Shriyans406/FLYBACK-CONVERTER/pcb/fab/ERC_report.txt

ERC report (2026-11-11T09:52:20, Encoding UTF8)
Report includes: Errors, Warnings, Exclusions

***** Sheet /

 ** ERC messages: 0  Errors 0  Warnings 0

 ** Ignored checks:
    - Global label only appears once in the schematic
    - Four connection points are joined together
    - SPICE model issue
    - Assigned footprint doesn't match footprint filters
