Shriyans406/FLYBACK-CONVERTER/pcb/renders/bottom.png

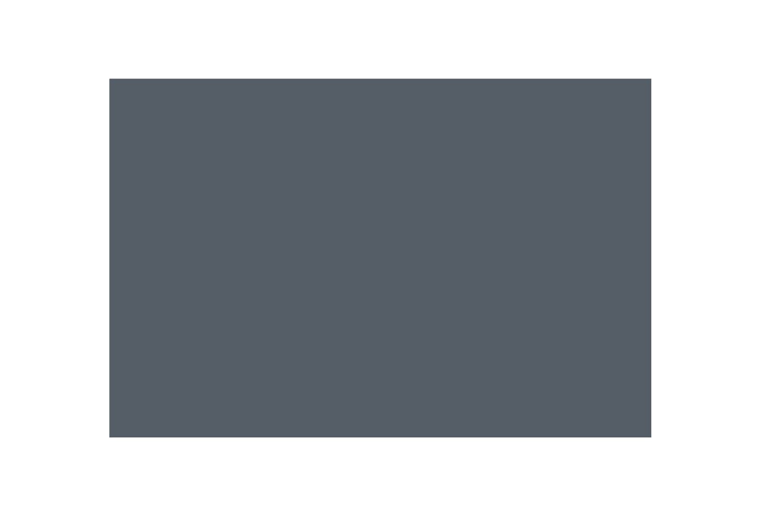
pcb/renders/bottom.png
