Shriyans406/FLYBACK-CONVERTER/pcb/renders/enclosure_view.png

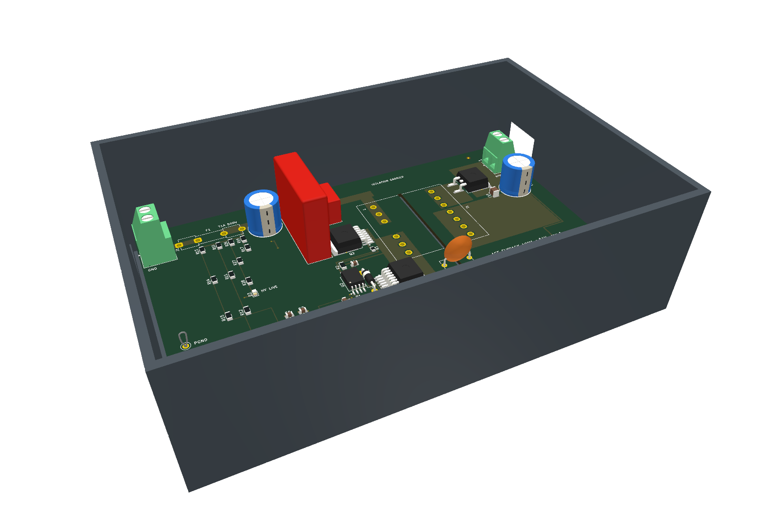
pcb/renders/enclosure_view.png
