Shriyans406/FLYBACK-CONVERTER/pcb/renders/top.png

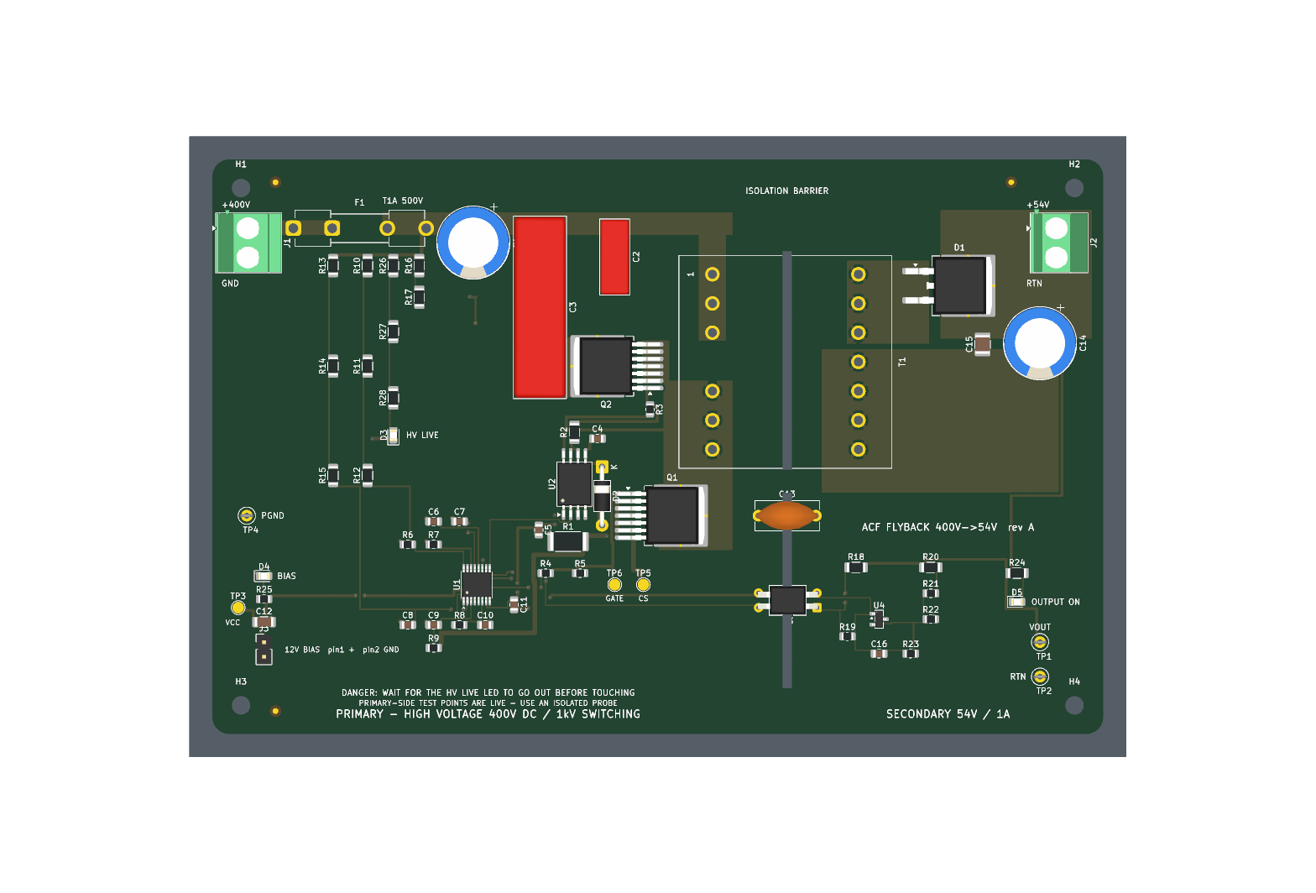
pcb/renders/top.png
