Shriyans406/FLYBACK-CONVERTER/pcb/fab/ACF_Flyback_BOM.csv

Qty | References | Value | Footprint | Description
1 | J1 | 400V DC IN | TerminalBlock_Phoenix_MKDS-3-2-5.08_1x02_P5.08mm_Horizontal | Phoenix MKDS 3/2-5,08
1 | F1 | T1A 500V | Fuseholder_Clip-5x20mm_Keystone_3517_Inline_P23.11x6.76mm_D1.70mm_Horizontal | Keystone 3517 clips + 5x20 fuse
1 | C1 | 22u 450V | CP_Radial_D12.5mm_P5.00mm | bulk electrolytic
1 | C2 | 100n 630V | C_Rect_L13.0mm_W5.0mm_P10.00mm_FKS3_FKP3_MKS4 | film, HF loop bypass
1 | C3 | 470n 1kV | C_Rect_L31.5mm_W9.0mm_P27.50mm_MKS4 | film clamp capacitor
1 | T1 | 25mH 10:1 | Transformer_EPCOS_B66359A1013T_Horizontal | PLACEHOLDER ETD29 bobbin - see notes
1 | Q1 | IMBF170R1K0M1 | TO-263-7_TabPin8 | Infineon 1700V SiC, main switch
1 | Q2 | IMBF170R1K0M1 | TO-263-7_TabPin8 | Infineon 1700V SiC, clamp switch
1 | R1 | 0R27 1W | R_2512_6332Metric | current sense
1 | U2 | UCC5350SBDWV | SOIC-8_7.5x5.85mm_P1.27mm | isolated high-side gate driver
1 | C4 | 1u 25V | C_0805_2012Metric | bootstrap capacitor
1 | R2 | 10R | R_1206_3216Metric | Q2 gate resistor
1 | R3 | 10k | R_0805_2012Metric | Q2 gate pull-down
1 | D2 | STTH112 | D_DO-41_SOD81_P10.16mm_Horizontal | 1200V bootstrap diode
1 | C5 | 100n | C_0805_2012Metric | U2 input decoupling
1 | R4 | 10R | R_0805_2012Metric | Q1 gate resistor
1 | R5 | 10k | R_0805_2012Metric | Q1 gate pull-down
1 | U1 | LM5025 | TSSOP-16_4.4x5mm_P0.65mm | active-clamp PWM controller
1 | R6 | 22k | R_0805_2012Metric | UVLO divider bottom
1 | R7 | 680k | R_0805_2012Metric | oscillator (10 kHz, see notes)
1 | C6 | 100n | C_0805_2012Metric | soft-start
1 | C7 | 1n | C_0805_2012Metric | COMP noise filter
1 | C8 | 1n | C_0805_2012Metric | ramp capacitor
1 | C9 | 220p | C_0805_2012Metric | current-sense filter
1 | R8 | 160k | R_0805_2012Metric | dead-time set
1 | C10 | 100n | C_0805_2012Metric | REF decoupling
1 | R9 | 1k | R_0805_2012Metric | current-sense filter
1 | C11 | 1u 25V | C_0805_2012Metric | VCC decoupling
1 | C12 | 10u 25V | C_1206_3216Metric | VCC bulk
1 | J3 | 12V BIAS | PinHeader_1x02_P2.54mm_Vertical | primary-referenced 12 V bias input
3 | R10 R11 R12 | 1M | R_1206_3216Metric | UVLO divider
3 | R13 R14 R15 | 1M | R_1206_3216Metric | ramp feed-forward
2 | R16 R17 | 470k | R_1206_3216Metric | bulk bleeder
1 | C13 | 2n2 Y1 | C_Disc_D11.0mm_W5.0mm_P10.00mm | Y1 safety capacitor
1 | U3 | LTV-817M | DIP-4_W10.16mm | optocoupler, 10.16 mm lead form
1 | D1 | RB218NS150 | TO-263-2 | 150V 20A Schottky
1 | C14 | 180u 100V | CP_Radial_D12.5mm_P5.00mm | output electrolytic, low ESR
1 | C15 | 1u 100V | C_1210_3225Metric | output ceramic
1 | J2 | 54V OUT | TerminalBlock_Phoenix_MKDS-1,5-2-5.08_1x02_P5.08mm_Horizontal | Phoenix MKDS 1,5/2-5,08
1 | U4 | TL431 | SOT-23 | shunt reference (check K/R/A pin order of chosen vendor)
1 | R18 | 22k | R_1206_3216Metric | opto LED feed
1 | R19 | 1k | R_0805_2012Metric | TL431 bias
1 | R20 | 200k | R_1206_3216Metric | feedback divider top
1 | R21 | 6k2 | R_0805_2012Metric | feedback divider top
1 | R22 | 10k | R_0805_2012Metric | feedback divider bottom
1 | C16 | 100n | C_0805_2012Metric | Type-II compensation
1 | R23 | 10k | R_0805_2012Metric | Type-II compensation
3 | R26 R27 R28 | 220k | R_1206_3216Metric | HV-live LED dropper
1 | D3 | RED | LED_0805_2012Metric | HV LIVE indicator (bulk capacitor charged)
1 | R25 | 4k7 | R_0805_2012Metric | bias LED resistor
1 | D4 | YELLOW | LED_0805_2012Metric | 12 V BIAS indicator
1 | R24 | 27k | R_1206_3216Metric | output LED resistor
1 | D5 | GREEN | LED_0805_2012Metric | OUTPUT ON indicator
1 | TP1 | VOUT | TestPoint_Loop_D2.50mm_Drill1.0mm | probe loop, +54 V output
1 | TP2 | SGND | TestPoint_Loop_D2.50mm_Drill1.0mm | probe loop, output return
1 | TP4 | PGND | TestPoint_Loop_D2.50mm_Drill1.0mm | probe loop, primary ground
