Shriyans406/FLYBACK-CONVERTER/pcb/enclosure/ACF_enclosure_base.stl

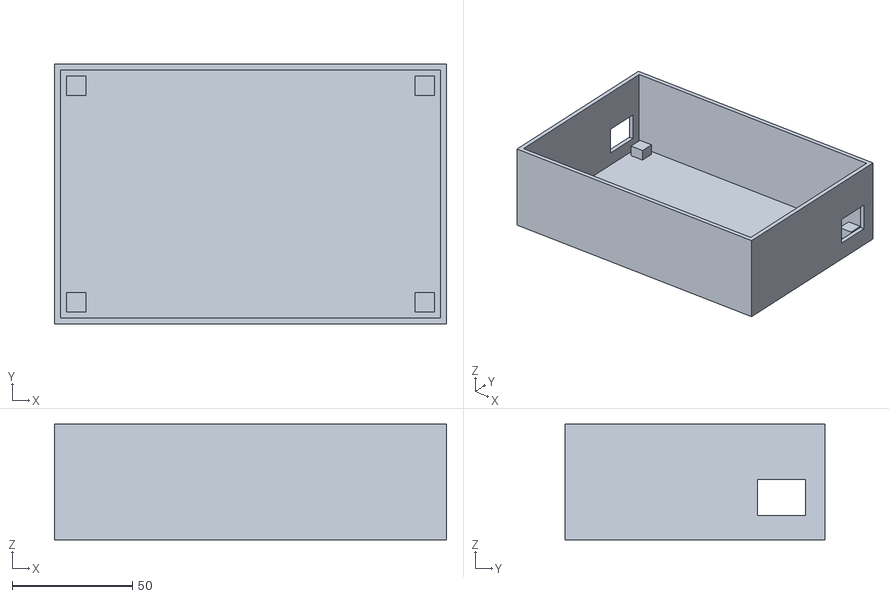
[picture p4: CAD file, 2026-11-11]
pcb/enclosure/ACF_enclosure_base.stl
163.0 x 108.0 x 48.1
