Shriyans406/FLYBACK-CONVERTER/pcb/enclosure/ACF_enclosure_lid.stl

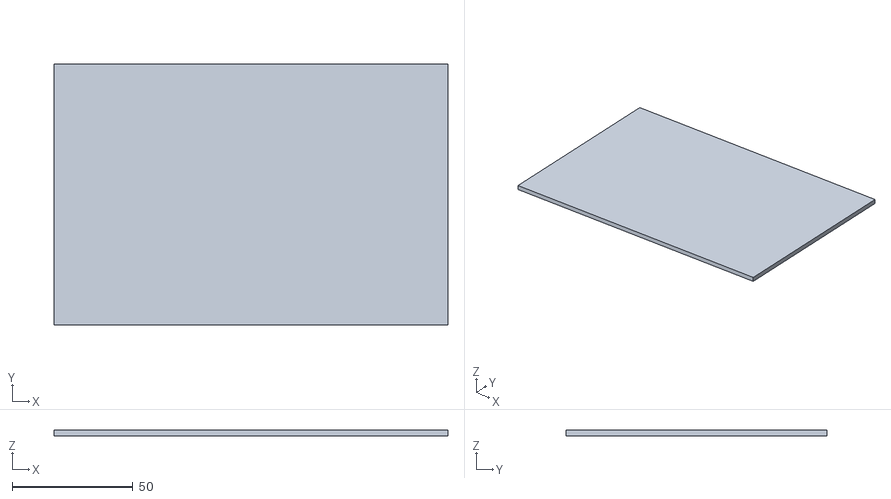
[picture p5: CAD file, 2026-11-11]
pcb/enclosure/ACF_enclosure_lid.stl
163.0 x 108.0 x 2.50
