Shriyans406/FLYBACK-CONVERTER/ACF_verification.png

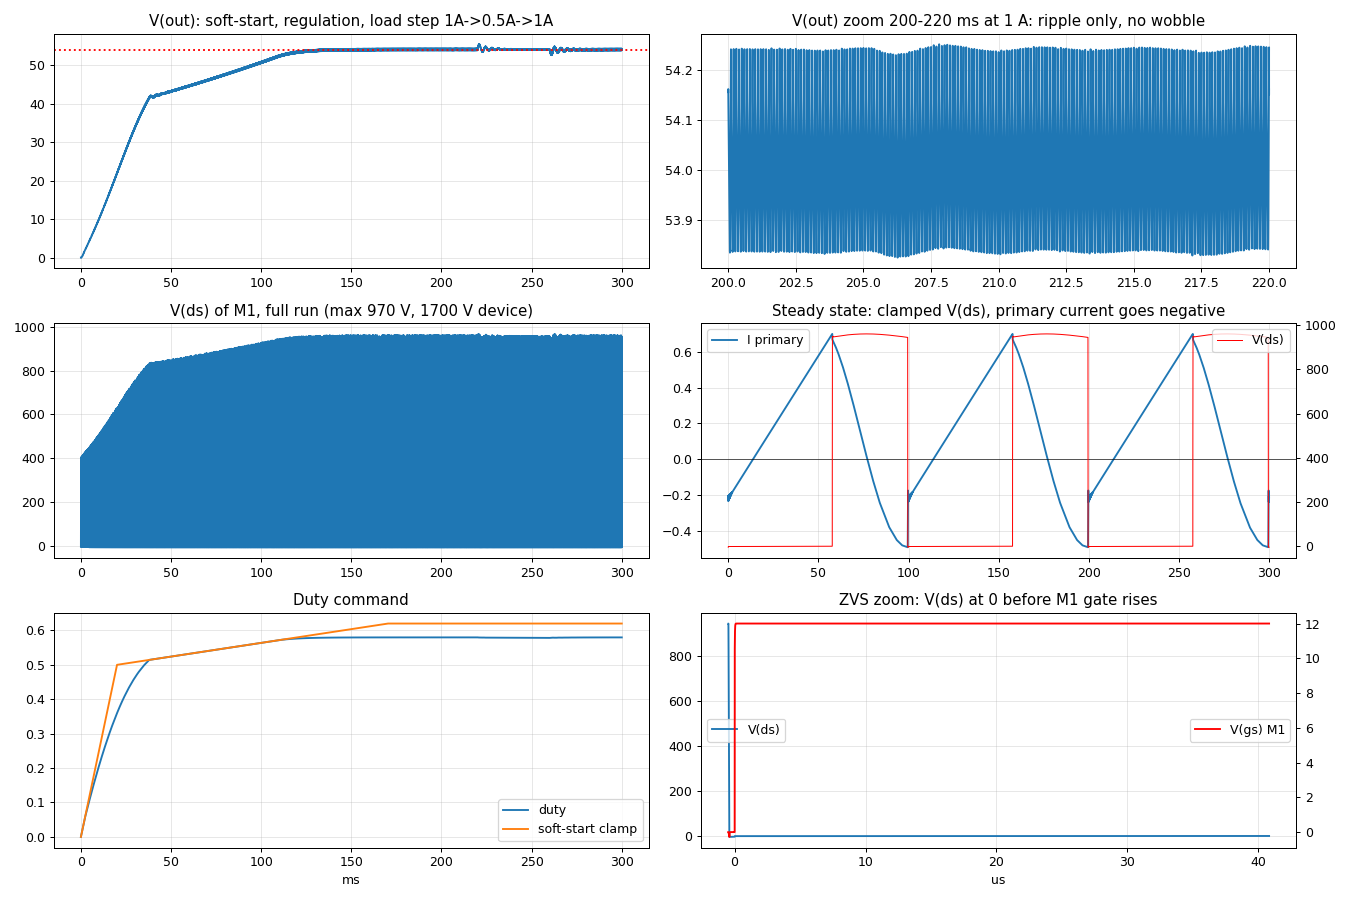
ACF_verification.png
