Shriyans406/FLYBACK-CONVERTER/pcb/fab/ACF_Flyback_schematic.pdf

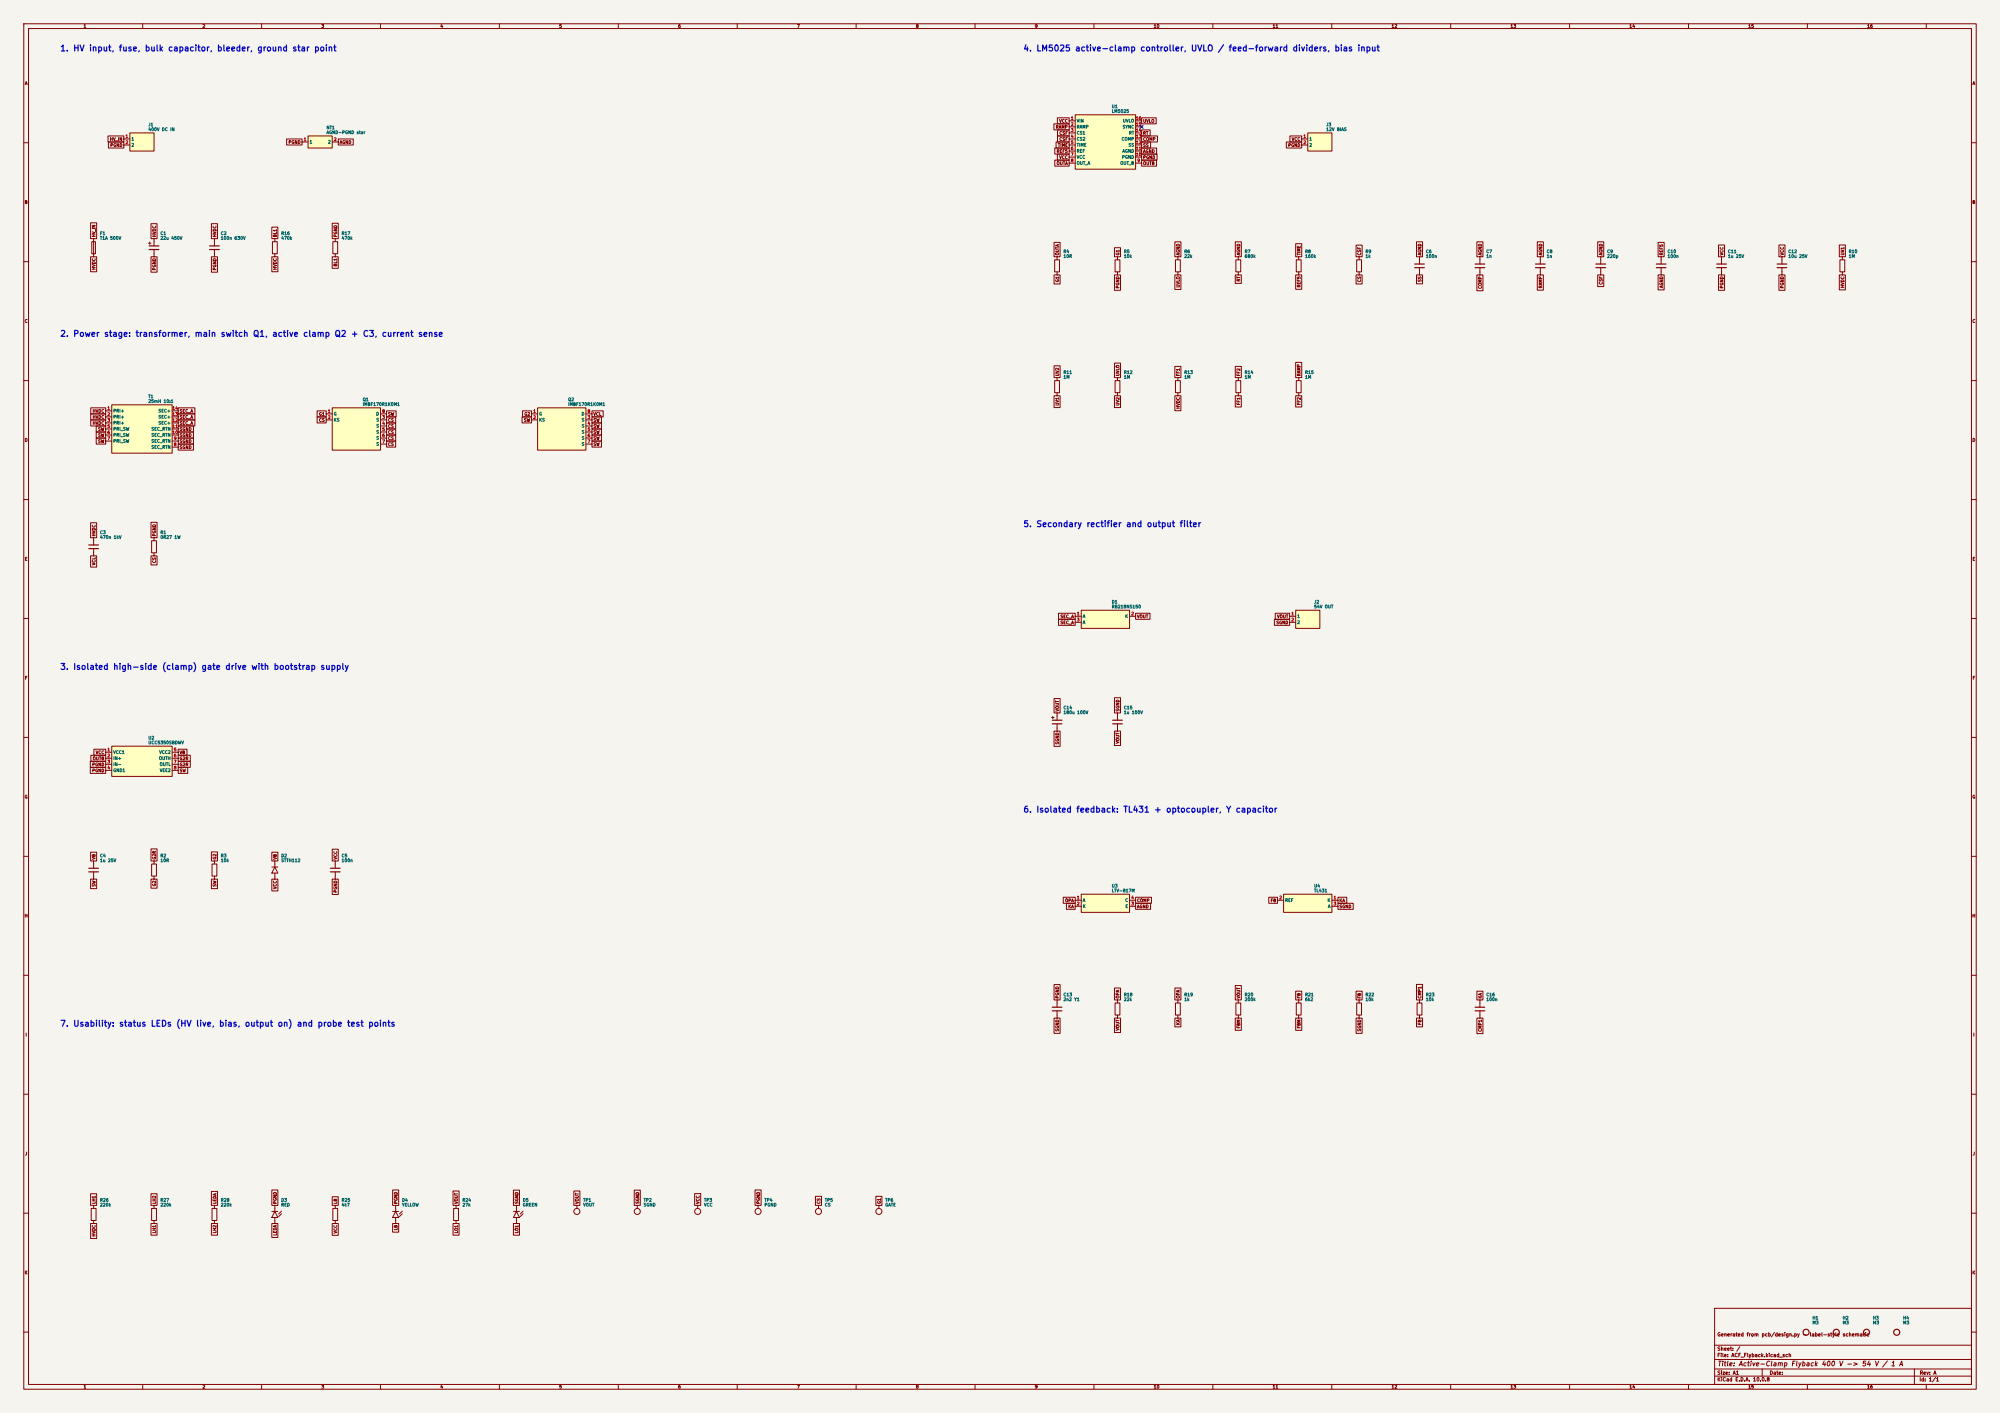
[picture p7: page 1]

1. HV input, fuse, bulk capacitor, bleeder, ground star point

4. LM5025 active-clamp controller, UVLO / feed-forward dividers, bias input

2. Power stage: transformer, main switch Q1, active clamp Q2 + C3, current sense

SGND HVDC HVDC HVDC

5. Secondary rectifier and output filter

3. Isolated high-side (clamp) gate drive with bootstrap supply

6. Isolated feedback: TL431 + optocoupler, Y capacitor

7. Usability: status LEDs (HV live, bias, output on) and probe test points

Generated from pcb/design.py - label-style schematic

Sheet: /
File: ACF_Flyback.kicad_sch
Title: Active-Clamp Flyback 400 V -> 54 V / 1 A

Size: A1 | Rev: A
KiCad E.D.A. 10.0.8 | Id: 1/1
