Shriyans406/FLYBACK-CONVERTER/07-06-26_Sunday_FLyback.asc

Cclamp: cap; 10n
Cin: cap; 100n
Co2: cap; 470µ
D1: diode; 1N4007
L1: ind2; 500µ
L2: ind2; 5µ
M1: nmos; MY_NMOS
M2: pmos; IRF9640
R1: res; 10
Vgate2: voltage; PULSE(400 390 5.2u 10n 10n 4.4u 10u)
Vgate: voltage; PULSE(0 10 0 10n 10n 5u 10u)
Vin: voltage; 400
Named nets: 0
K1 L1 L2 0.98
.tran 0 5m 2m startup
.model MY_NMOS NMOS(Vto=4 Kp=20 TOX=20n CGSO=1n CGDO=50p)
