Shriyans406/FLYBACK-CONVERTER/11-07-26.asc

B1: bv; V=ls(V(ramp),V(duty),V(clk))
B2: bv; V=hs(V(ramp),V(duty),V(clk))
Baw: bi; I=0.1*(max(V(v_err)-V(ss),0)-max(-V(v_err),0))
Bduty: bv; V=limit(min(V(v_err),V(ss)),0,0.62)
C1: cap; 180u; Rser=30m
C2: cap; 4.7u
C3: cap; 100n
Cclamp: cap; 470n
D1: schottky; RB218NS150
Istep: current; PWL(0 0 220m 0 220.1m -0.5 260m -0.5 260.1m 0)
L1: ind2; 25m; Rser=2
L2: ind2; 250u; Rser=20m
M1: nmos; IMBF170R1K0M1
M2: nmos; IMBF170R1K0M1
R1: res; 54
R2: res; 47
Rfb1: res; 515k
Rfb2: res; 25k
Ron1: res; 10
Ron2: res; 10
U1: opamp
V1: voltage; 2.5
Vclk: voltage; PULSE(0 1 0 10n 10n 99.5u 100u)
Vin1: voltage; 400
Vramp1: voltage; PULSE(0 1 0 99.5u 0.1u 0 100u)
Vss: voltage; PWL(0 0 20m 0.5 170m 0.62)
Named nets: 0, out, vpri, vsec, ctrl, gs, ds, vfb, v_err, ramp, vcl, g2, ctrl2, clk, ss, duty
K1 L1 L2 0.99
.tran 0 300m 0 startup
.model IMBF170R1K0M1 VDMOS(Rg=35 Vto=4.5 Kp=0.2 Rd=0.3 Rs=0.03 Cgs=274p Cgdmin=0.7p Cgdmax=60p A=0.5 Cjo=119p M=0.5 Vj=3 Is=1e-15 N=4 Rb=0.2 BV=1700 Vds=1700 Ron=1 Qg=5n mfg=Infineon)
.func ls(r,d,c) {if((r<d)&(c>0.5),12,0)}
.func hs(r,d,c) {if((r>d+0.005)&(c>0.5),12,0)}
.options reltol=0.001 cshunt=1p method=gear
.lib opamp.sub
.meas TRAN vout_avg AVG V(out) FROM 200m TO 220m
.meas TRAN vout_pp PP V(out) FROM 219m TO 220m
.meas TRAN pin AVG -V(vpri)*I(Vin1) FROM 200m TO 220m
.meas TRAN pout AVG V(out)*V(out)/54 FROM 200m TO 220m
.meas TRAN eff PARAM pout/pin
.meas TRAN duty_avg AVG V(duty) FROM 200m TO 220m
.meas TRAN vds_max MAX V(ds)
.meas TRAN vds_at_M1_turnon FIND V(ds) WHEN V(gs)=2 RISE=LAST
.meas TRAN vclamp_avg AVG V(vcl)-V(vpri) FROM 200m TO 220m
ACTIVE-CLAMP FLYBACK 400V -> 54V/1A, 10kHz, n=10:1
;M1/M2 = Infineon IMBF170R1K0M1 (1700V, 1 ohm SiC), datasheet-fit model
;Cclamp+M2 replace the RCD snubber: leakage energy is recycled
;Lm=25mH: magnetising current swings negative -> ZVS, no dead-time ringing
;hs/ls = complementary PWM with 0.5us dead-time
;Vss/Baw = duty soft-start + error-amp anti-windup clamp
;Istep = 1A -> 0.5A -> 1A load step (220-260ms) to check the loop
