Shriyans406/FLYBACK-CONVERTER/11-07-26_RCD_original.asc

B1: bv; V = IF((V(ramp) < V(v_err)) & (V(ramp) < 0.9), 10, 0)
C1: cap; 470µ
C2: cap; 2.798µ
C3: cap; 10.36n
Csnub1: cap; 14.5n
D1: schottky; RB218NS150
D2: schottky; RB218NS150
L1: ind2; 572µ
L2: ind2; 5.72µ
M1: nmos; REAL_MOSFET
R1: res; 54
R2: res; 4534.1
Rfb1: res; 51.5k
Rfb2: res; 2.5k
Ron1: res; 10
Rsnub1: res; 243.781k
U1: opamp
V1: voltage; 2.5
Vin1: voltage; 400
Vramp1: voltage; PULSE(0 1 0 99.9u 0.1u 0 100u)
Named nets: 0, out, d2, vpri, vsec, ctrl, gs, ds, vfb, v_err, ramp
K1 L1 L2 0.99
.tran 0 100m 2m startup
.model IDEAL_MOS NMOS(Vto=2 Kp=10000 Rd=0.001)
.lib opamp.sub
.model REAL_MOSFET NMOS(Vto=4 Kp=15 Rd=1.0 Cgso=50p Cgdo=10p)
.options reltol=0.01
.options cshunt=1p
.options method=gear
