Shriyans406/FLYBACK-CONVERTER/12-06-2026_basic_flyback.asc

C1: cap; 40.8µ
C2: cap; 1.1µ
C3: cap; 22n
C4: cap; 100p
D1: diode; MUR460
L1: ind2; 500µ
L2: ind2; 5µ
M1: nmos; STW11NM80
M2: nmos; STW11NM80
R1: res; 54
Vgate1: voltage; PULSE(0 10 0 10n 10n 1.84u 10u)
Vgate2: voltage; PULSE(0 10 1.94u 10n 10n 2u 10u)
Vin: voltage; 400
Named nets: 0
K1 L1 L2 0.98
.tran 0 10m 2m startup
