Shriyans406/FLYBACK-CONVERTER/Draft1.asc

Cin1: cap; 100n
Co1: cap; 470µ
Csnub: cap; 2.2n
D1: diode; FAST_DIODE
D2: diode; FAST_DIODE
L1: ind2; 500µ
L2: ind2; 5µ
M1: nmos; MY_NMOS
R1: res; 10
Rsnub: res; 5k
Vgate1: voltage; PULSE(0 10 0 10n 10n 5u 10u)
Vgate2: voltage; PULSE(400 390 5.2u 10n 10n 4.4u 10u)
Vin1: voltage; 400
Named nets: 0
K1 L1 L2 0.98
.tran 0 5m 2m startup
.model MY_NMOS NMOS(Vto=4 Kp=20 TOX=20n CGSO=1n CGDO=50p)
.model FAST_DIODE D(Is=10n Rs=0.05 N=1.5 Cjo=50p tt=50n BV=800)
