Shriyans406/FLYBACK-CONVERTER/Draft2.asc

Co1: cap; 100µ
Csnub1: cap; 1µ
D1: diode; FAST_DIODE
D2: diode; FAST_DIODE
L1: ind2; 50µ
L2: ind2; 0.5µ
M1: nmos; MY_NMOS
R1: res; 54
Rsnub1: res; 9K
Vgate1: voltage; PULSE(0 10 0 10n 10n 3.215u 10u)
Vin1: voltage; 400
Named nets: 0
K1 L1 L2 0.98
.tran 0 10m 2m startup
.model MY_NMOS NMOS(Vto=4 Kp=20 TOX=20n CGSO=1n CGDO=50p)
.model FAST_DIODE D(Is=10n Rs=0.05 N=1.5 Cjo=50p tt=50n BV=800)
