Shriyans406/FLYBACK-CONVERTER/Draft4.asc

C1: cap; 40.8µ
D1: diode; MUR460
L1: ind2; 572µ
L2: ind2; 5.72µ
R1: res; 54
S1: sw; MY_SWITCH
V1: voltage; PULSE(0 10 0 1n 1n 1.965u 10u)
Vin1: voltage; 400
Named nets: 0
K1 L1 L2 1
.tran 0 10m 2m startup
.model MY_SWITCH SW(Ron=0.001 Roff=100Meg Vt=5)
