Shriyans406/FLYBACK-CONVERTER/Draft5.asc

C1: cap; 470µ
Csnub1: cap; 1n
D1: schottky; RB218NS150
D2: diode; RF305BM6S
L1: ind2; 572µ
L2: ind2; 5.72µ
R1: res; 54
Rsnub1: res; 103.813k
S1: sw; MY_SWITCH
V1: voltage; PULSE(0 10 0 10n 10n 5.745u 100u)
Vin1: voltage; 400
Named nets: 0, out, d2, vpri, vsec, ctrl, SW
K1 L1 L2 1
.tran 0 50m 2m startup
.model MY_SWITCH SW(Ron=0.001 Roff=100Meg Vt=5)
