Shriyans406/FLYBACK-CONVERTER/FLYBACK.asc

Cclamp: cap; 100n
Cout: cap; 470µ; V=50
D1: diode; MUR460
Lp: ind2; 500µ
Ls: ind2; 5µ
Rload: res; 10
SW1: nmos
SW2: nmos
V1: voltage; 400
Vgate2: voltage; PULSE(0 10 5.2u 10n 10n 4.4u 10u)
Vgate: voltage; PULSE(0 10 0 10n 10n 5u 10u)
Named nets: 0
K1 Lp Ls 0.98
.tran 0 5m startup
.model SW1 NMOS(VTO=4 KP=20)
.model SW2 NMOS(VTO=4 KP=20)
