Shriyans406/FLYBACK-CONVERTER/pcb/ACF_Flyback.kicad_pcb

## KiCad design pcb/ACF_Flyback.kicad_pcb (2026-11-11)

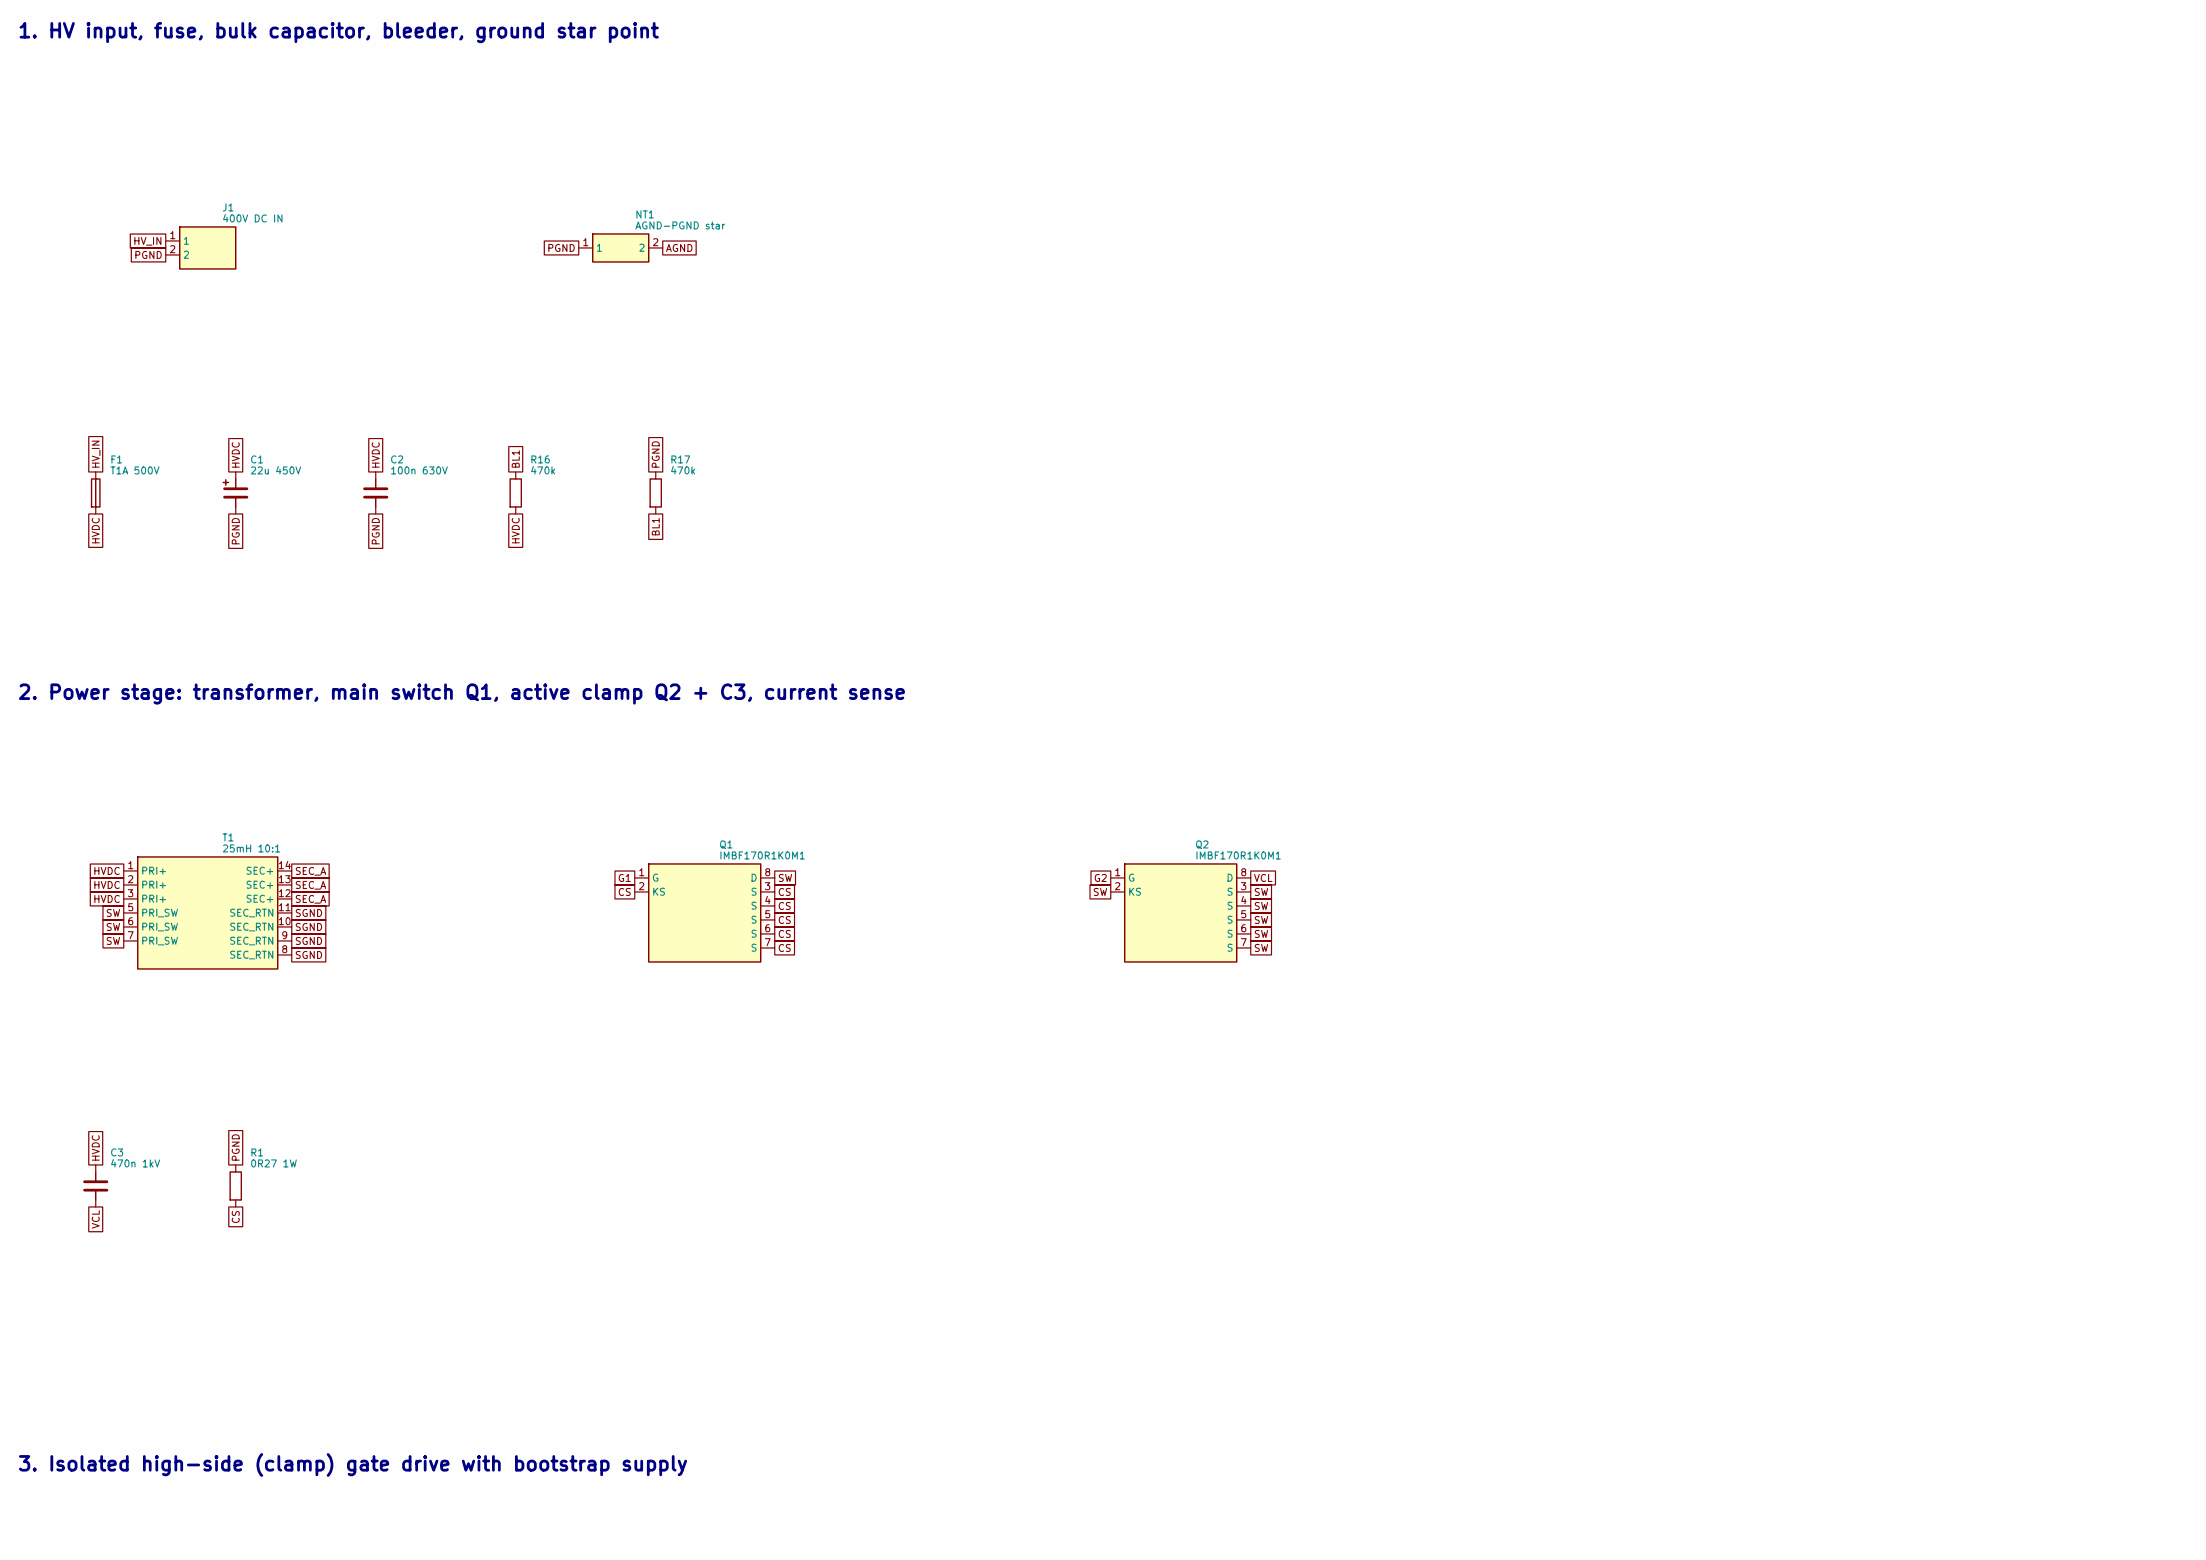
[picture p8: schematic ACF_Flyback.kicad_sch, Active-Clamp Flyback 400 V -> 54 V / 1 A, part in row 1, column 1]

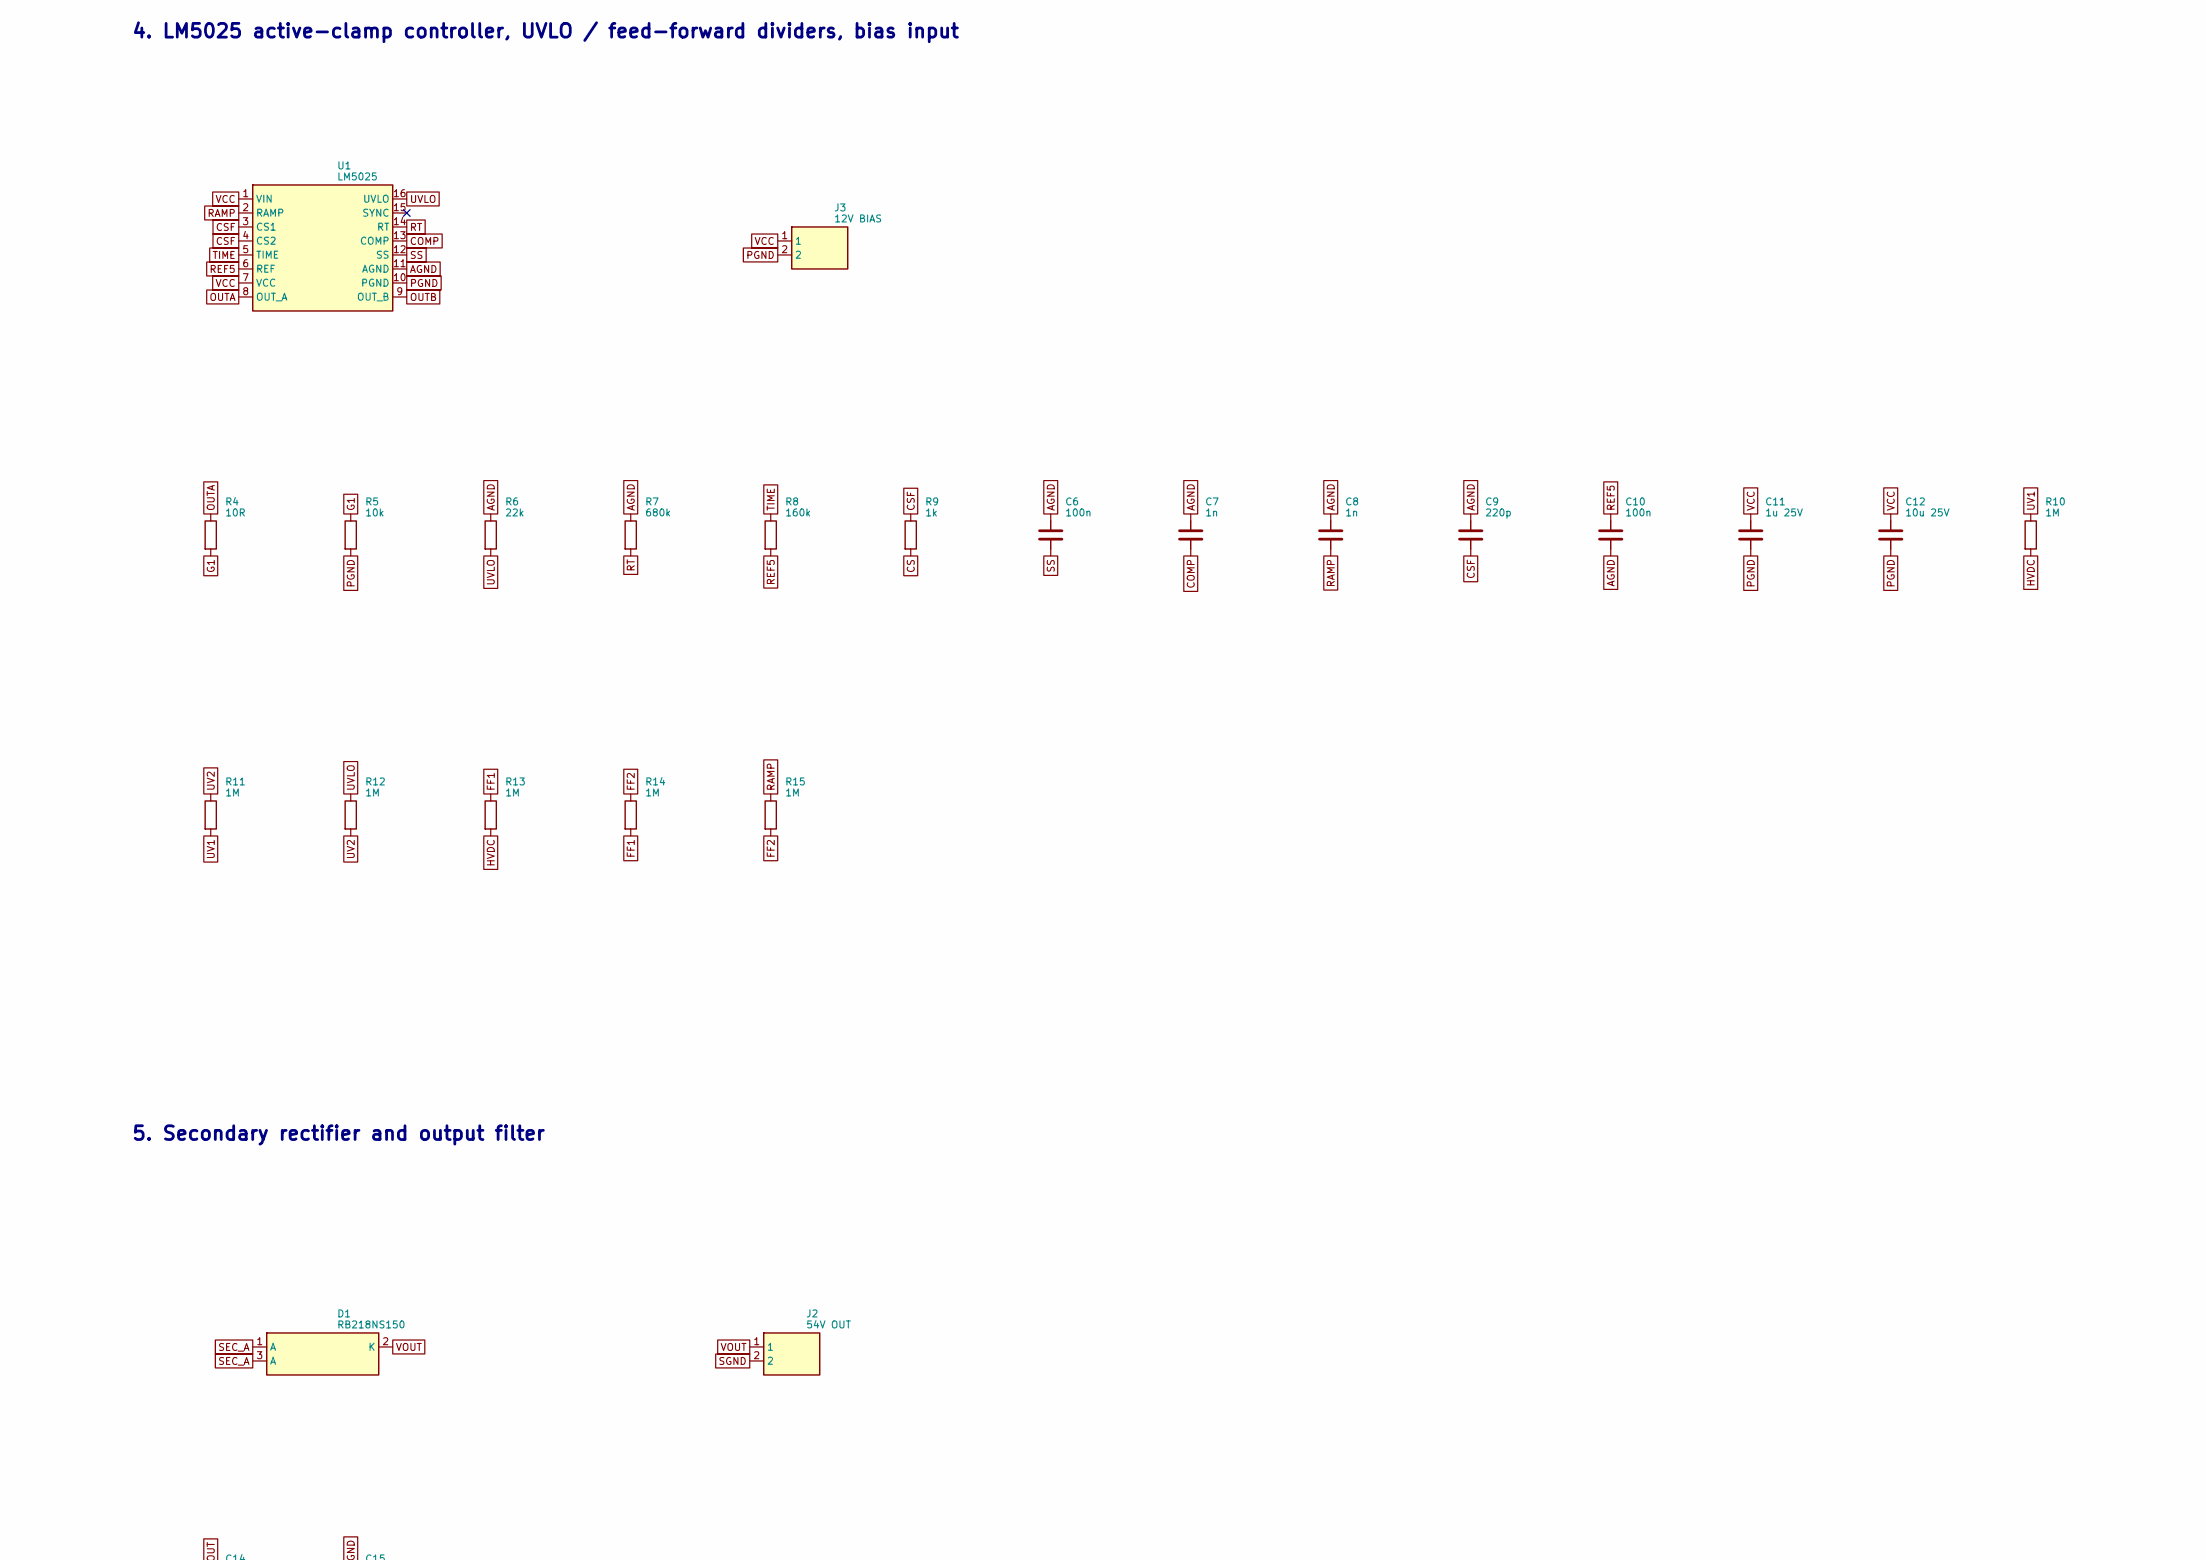
[picture p9: schematic ACF_Flyback.kicad_sch, Active-Clamp Flyback 400 V -> 54 V / 1 A, part in row 1, column 2]

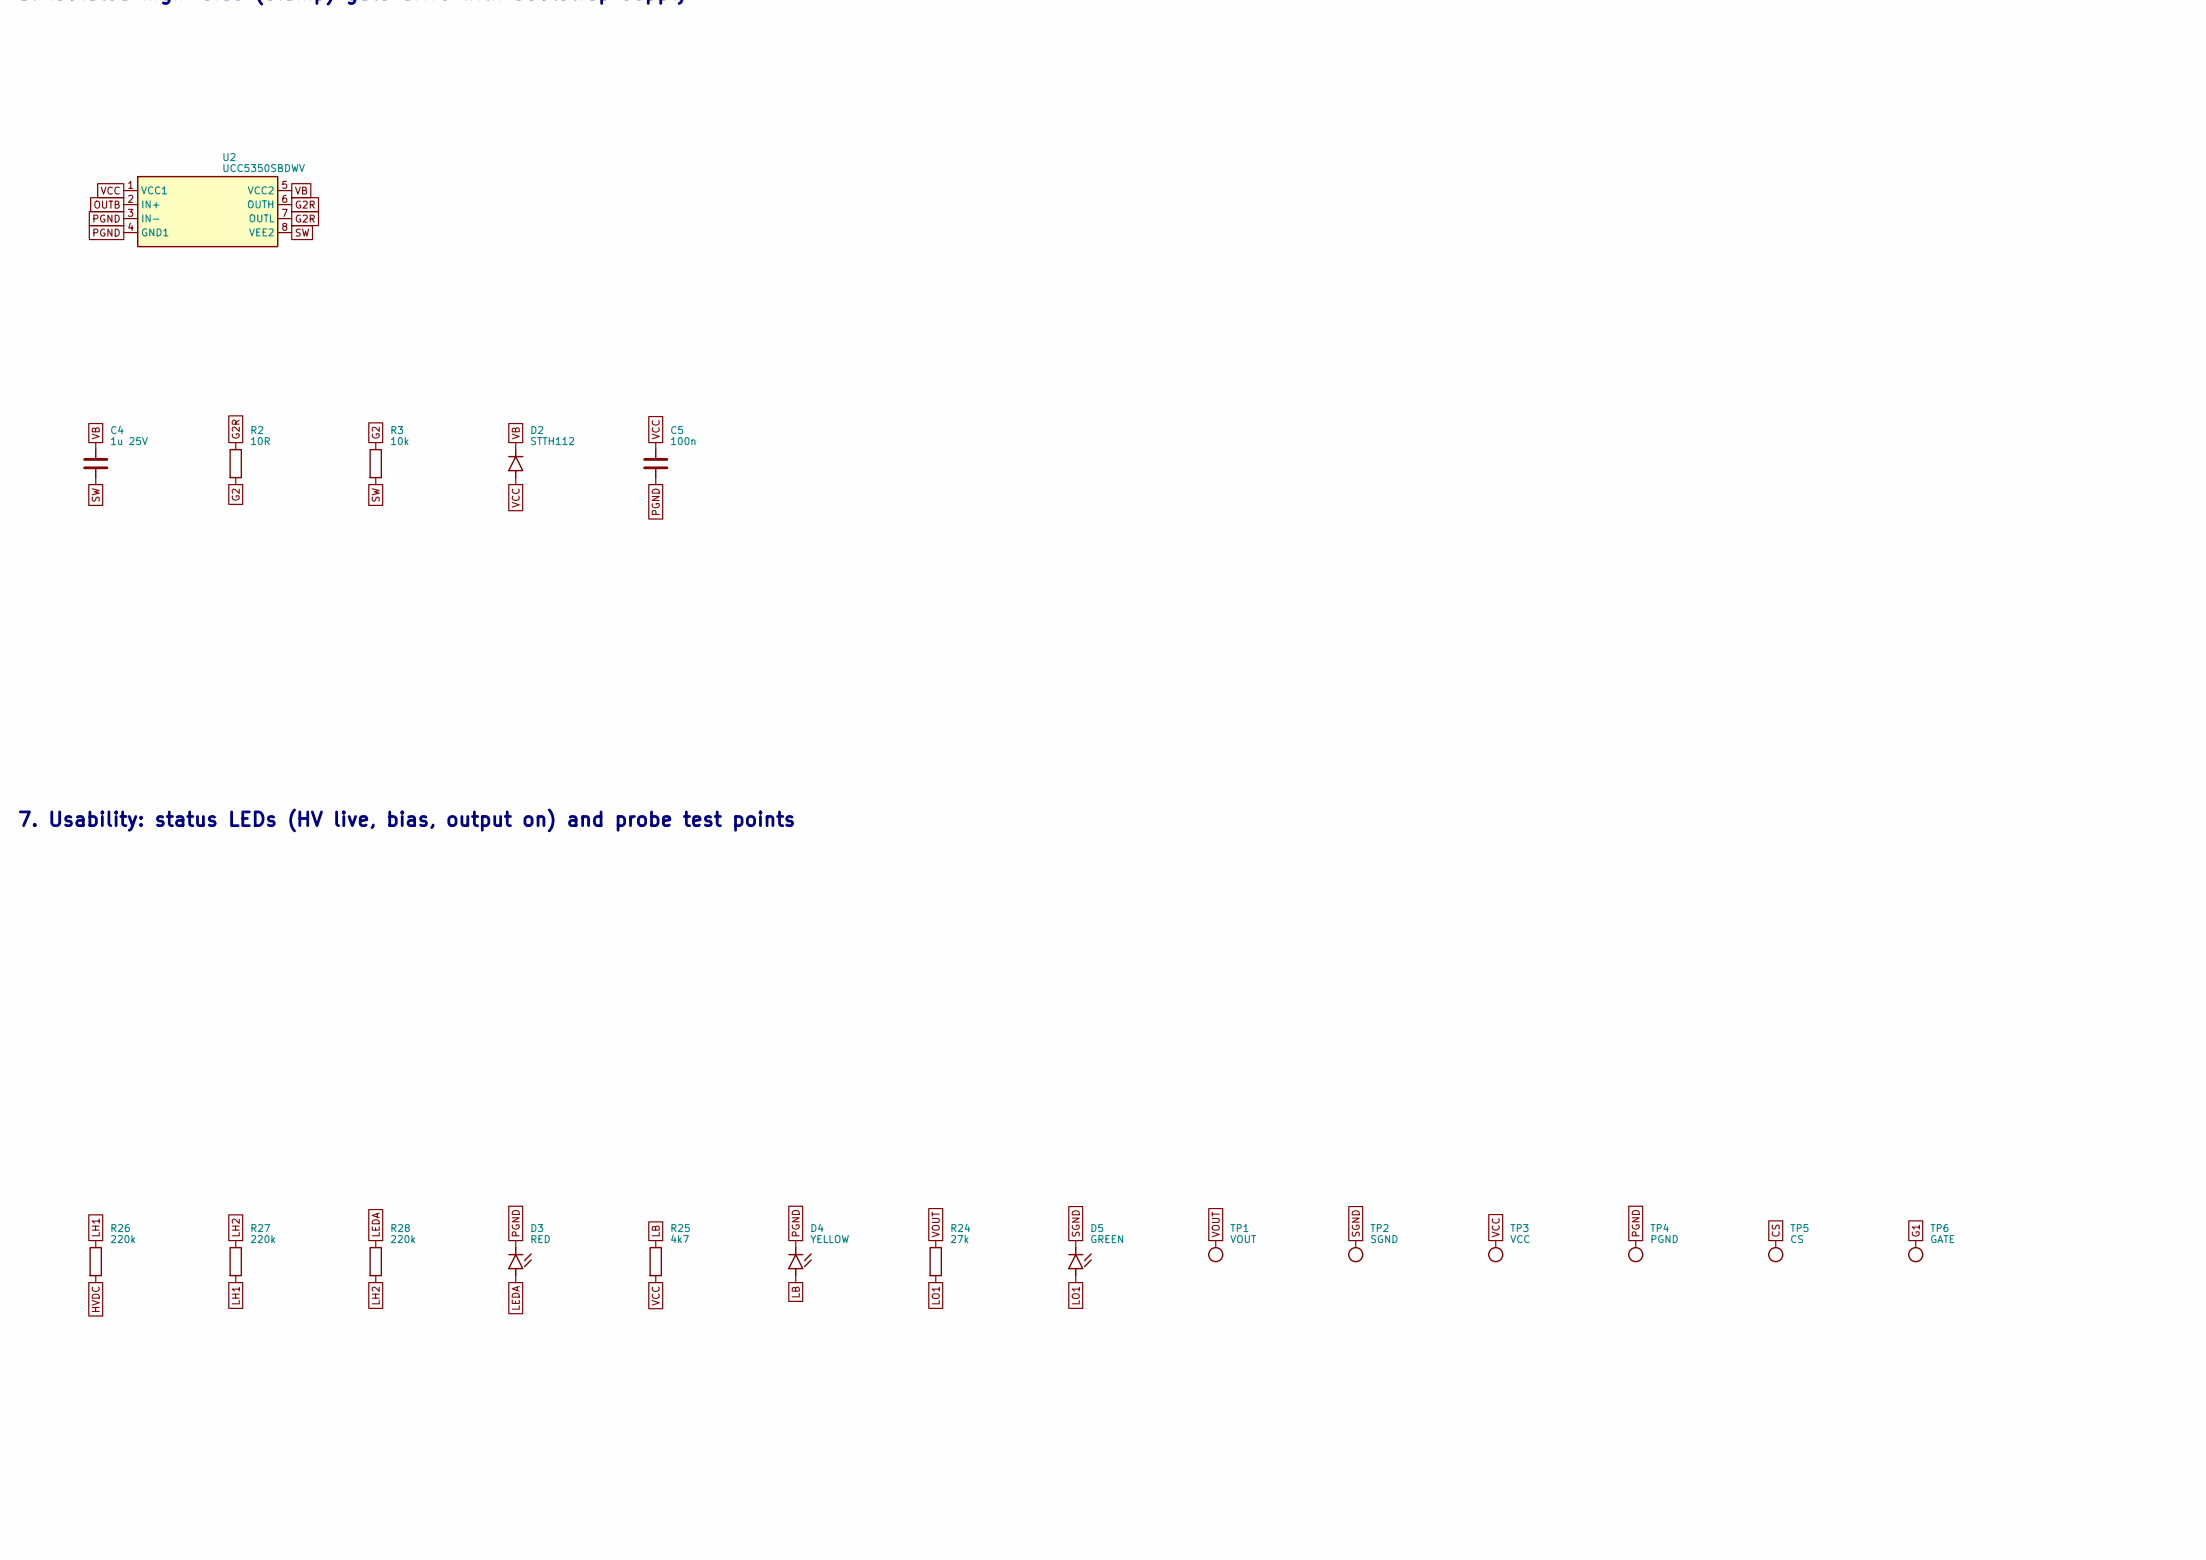
[picture p10: schematic ACF_Flyback.kicad_sch, Active-Clamp Flyback 400 V -> 54 V / 1 A, part in row 2, column 1]

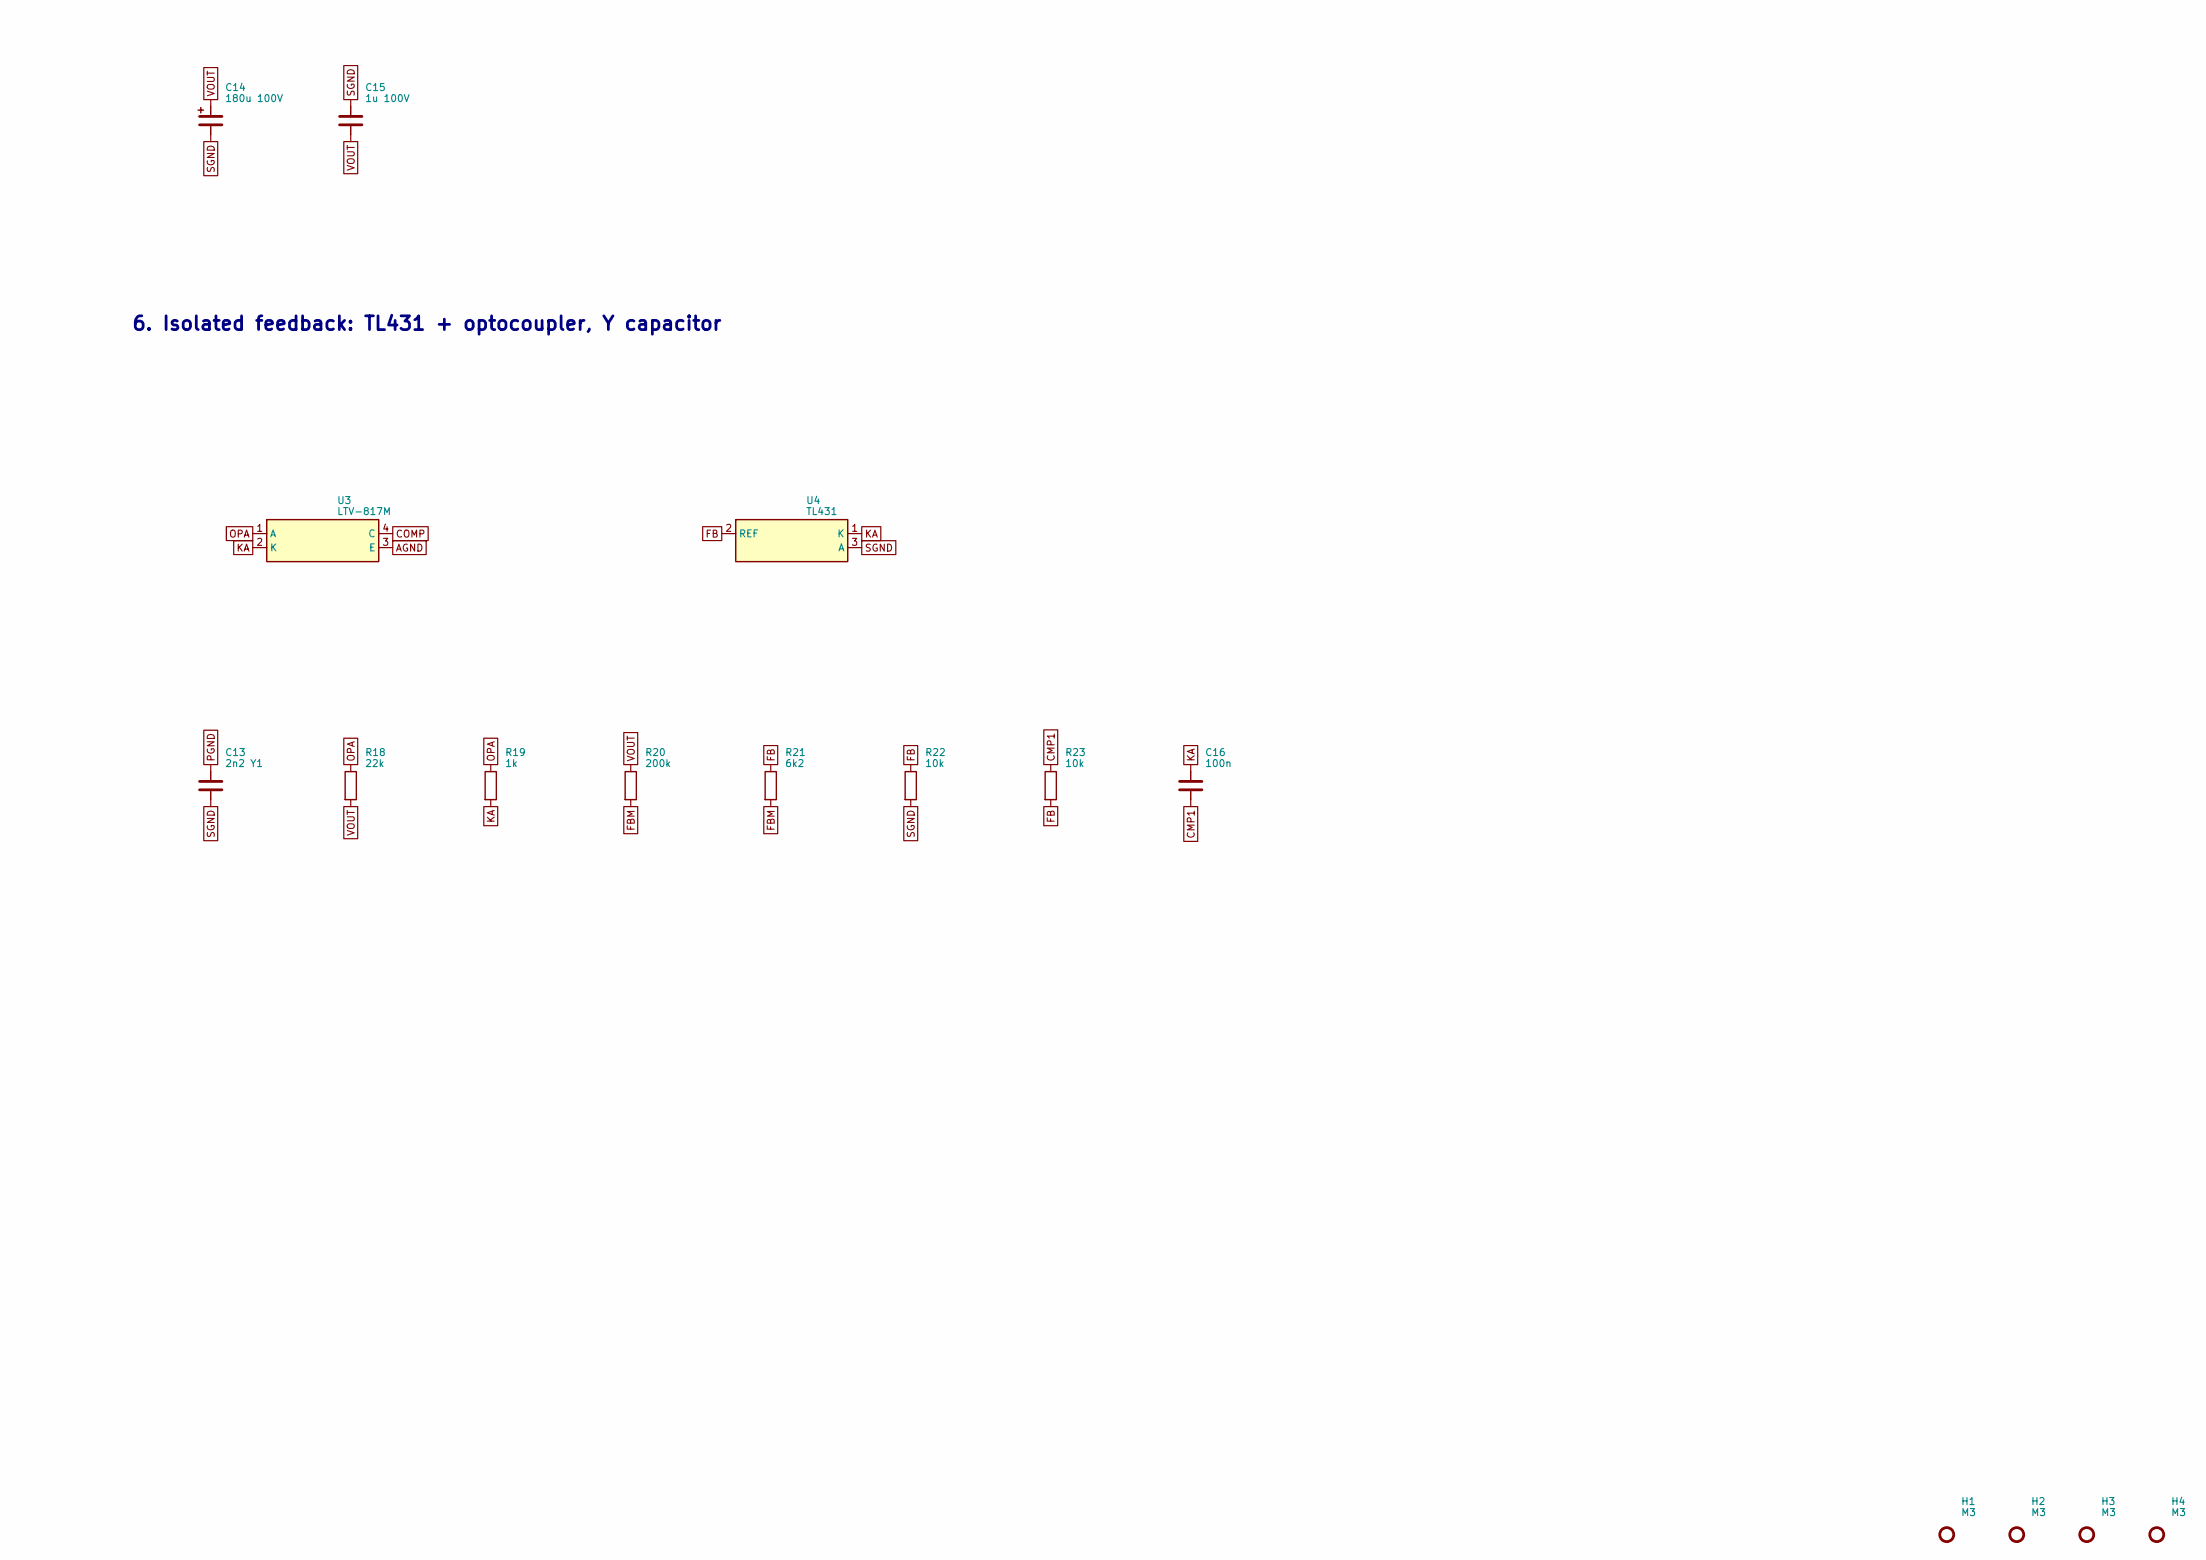
[picture p11: schematic ACF_Flyback.kicad_sch, Active-Clamp Flyback 400 V -> 54 V / 1 A, part in row 2, column 2]

Parts:
C1: 22u 450V; CP_Radial_D12.5mm_P5.00mm
C2: 100n 630V; C_Rect_L13.0mm_W5.0mm_P10.00mm_FKS3_FKP3_MKS4
C3: 470n 1kV; C_Rect_L31.5mm_W9.0mm_P27.50mm_MKS4
C4, C11: 1u 25V; C_0805_2012Metric
C5, C6, C10, C16: 100n; C_0805_2012Metric
C7, C8: 1n; C_0805_2012Metric
C9: 220p; C_0805_2012Metric
C12: 10u 25V; C_1206_3216Metric
C13: 2n2 Y1; C_Disc_D11.0mm_W5.0mm_P10.00mm
C14: 180u 100V; CP_Radial_D12.5mm_P5.00mm
C15: 1u 100V; C_1210_3225Metric
D1: RB218NS150; TO-263-2
D2: STTH112; D_DO-41_SOD81_P10.16mm_Horizontal
D3: RED; LED_0805_2012Metric
D4: YELLOW; LED_0805_2012Metric
D5: GREEN; LED_0805_2012Metric
F1: T1A 500V; Fuseholder_Clip-5x20mm_Keystone_3517_Inline_P23.11x6.76mm_D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
H1, H2, H3, H4: M3; MountingHole_3.2mm_M3
J1: 400V DC IN; TerminalBlock_Phoenix_MKDS-3-2-5.08_1x02_P5.08mm_Horizontal
J2: 54V OUT; TerminalBlock_Phoenix_MKDS-1,5-2-5.08_1x02_P5.08mm_Horizont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
J3: 12V BIAS; PinHeader_1x02_P2.54mm_Vertical
NT1: AGND-PGND star; NetTie-2_SMD_Pad0.5mm
Q1, Q2: IMBF170R1K0M1; TO-263-7_TabPin8
R1: 0R27 1W; R_2512_6332Metric
R2: 10R; R_1206_3216Metric
R3, R5, R22, R23: 10k; R_0805_2012Metric
R4: 10R; R_0805_2012Metric
R6: 22k; R_0805_2012Metric
R7: 680k; R_0805_2012Metric
R8: 160k; R_0805_2012Metric
R9, R19: 1k; R_0805_2012Metric
R10, R11, R12, R13, R14, R15: 1M; R_1206_3216Metric
R16, R17: 470k; R_1206_3216Metric
R18: 22k; R_1206_3216Metric
R20: 200k; R_1206_3216Metric
R21: 6k2; R_0805_2012Metric
R24: 27k; R_1206_3216Metric
R25: 4k7; R_0805_2012Metric
R26, R27, R28: 220k; R_1206_3216Metric
T1: 25mH 10:1; Transformer_EPCOS_B66359A1013T_Horizontal
TP1: VOUT; TestPoint_Loop_D2.50mm_Drill1.0mm
TP2: SGND; TestPoint_Loop_D2.50mm_Drill1.0mm
TP3: VCC; TestPoint_Pad_D2.0mm
TP4: PGND; TestPoint_Loop_D2.50mm_Drill1.0mm
TP5: CS; TestPoint_Pad_D2.0mm
TP6: GATE; TestPoint_Pad_D2.0mm
U1: LM5025; TSSOP-16_4.4x5mm_P0.65mm
U2: UCC5350SBDWV; SOIC-8_7.5x5.85mm_P1.27mm
U3: LTV-817M; DIP-4_W10.16mm
U4: TL431; SOT-23

Connections:
AGND: C6.1, C7.1, C8.1, C9.1, C10.2, NT1.2, R6.1, R7.1, U1.11 (AGND), U3.3 (E)
BL1: R16.1, R17.2
CMP1: C16.2, R23.1
COMP: C7.2, U1.13 (COMP), U3.4 (C)
CS: Q1.2 (KS), Q1.3 (S), Q1.4 (S), Q1.5 (S), Q1.6 (S), Q1.7 (S), R1.2, R9.2, TP5.1
CSF: C9.2, R9.1, U1.3 (CS1), U1.4 (CS2)
FB: R21.1, R22.1, R23.2, U4.2 (REF)
FBM: R20.2, R21.2
FF1: R13.1, R14.2
FF2: R14.1, R15.2
G1: Q1.1 (G), R4.2, R5.1, TP6.1
G2: Q2.1 (G), R2.2, R3.1
G2R: R2.1, U2.6 (OUTH), U2.7 (OUTL)
HVDC: C1.1, C2.1, C3.1, F1.2, R10.2, R13.2, R16.2, R26.2, T1.1 (PRI+), T1.2 (PRI+), T1.3 (PRI+)
HV_IN: F1.1, J1.1
KA: C16.1, R19.2, U3.2 (K), U4.1 (K)
LB: D4.2, R25.1
LEDA: D3.2, R28.1
LH1: R26.1, R27.2
LH2: R27.1, R28.2
LO1: D5.2, R24.2
OPA: R18.1, R19.1, U3.1 (A)
OUTA: R4.1, U1.8 (OUT_A)
OUTB: U1.9 (OUT_B), U2.2 (IN+)
PGND: C1.2, C2.2, C5.2, C11.2, C12.2, C13.1, D3.1, D4.1, J1.2, J3.2, NT1.1, R1.1, R5.2, R17.1, TP4.1, U1.10 (PGND), U2.3 (IN-), U2.4 (GND1)
RAMP: C8.2, R15.1, U1.2 (RAMP)
REF5: C10.1, R8.2, U1.6 (REF)
RT: R7.2, U1.14 (RT)
SEC_A: D1.1 (A), D1.3 (A), T1.12 (SEC+), T1.13 (SEC+), T1.14 (SEC+)
SGND: C13.2, C14.2, C15.1, D5.1, J2.2, R22.2, T1.8 (SEC_RTN), T1.9 (SEC_RTN), T1.10 (SEC_RTN), T1.11 (SEC_RTN), TP2.1, U4.3 (A)
SS: C6.2, U1.12 (SS)
SW: C4.2, Q1.8 (D), Q2.2 (KS), Q2.3 (S), Q2.4 (S), Q2.5 (S), Q2.6 (S), Q2.7 (S), R3.2, T1.5 (PRI_SW), T1.6 (PRI_SW), T1.7 (PRI_SW), U2.8 (VEE2)
TIME: R8.1, U1.5 (TIME)
UV1: R10.1, R11.2
UV2: R11.1, R12.2
UVLO: R6.2, R12.1, U1.16 (UVLO)
VB: C4.1, D2.1, U2.5 (VCC2)
VCC: C5.1, C11.1, C12.1, D2.2, J3.1, R25.2, TP3.1, U1.1 (VIN), U1.7 (VCC), U2.1 (VCC1)
VCL: C3.2, Q2.8 (D)
VOUT: C14.1, C15.2, D1.2 (K), J2.1, R18.2, R20.1, R24.1, TP1.1

Notes on the sheet:
1. HV input, fuse, bulk capacitor, bleeder, ground star point
2. Power stage: transformer, main switch Q1, active clamp Q2 + C3, current sense
3. Isolated high-side (clamp) gate drive with bootstrap supply
4. LM5025 active-clamp controller, UVLO / feed-forward dividers, bias input
5. Secondary rectifier and output filter
6. Isolated feedback: TL431 + optocoupler, Y capacitor
7. Usability: status LEDs (HV live, bias, output on) and probe test points

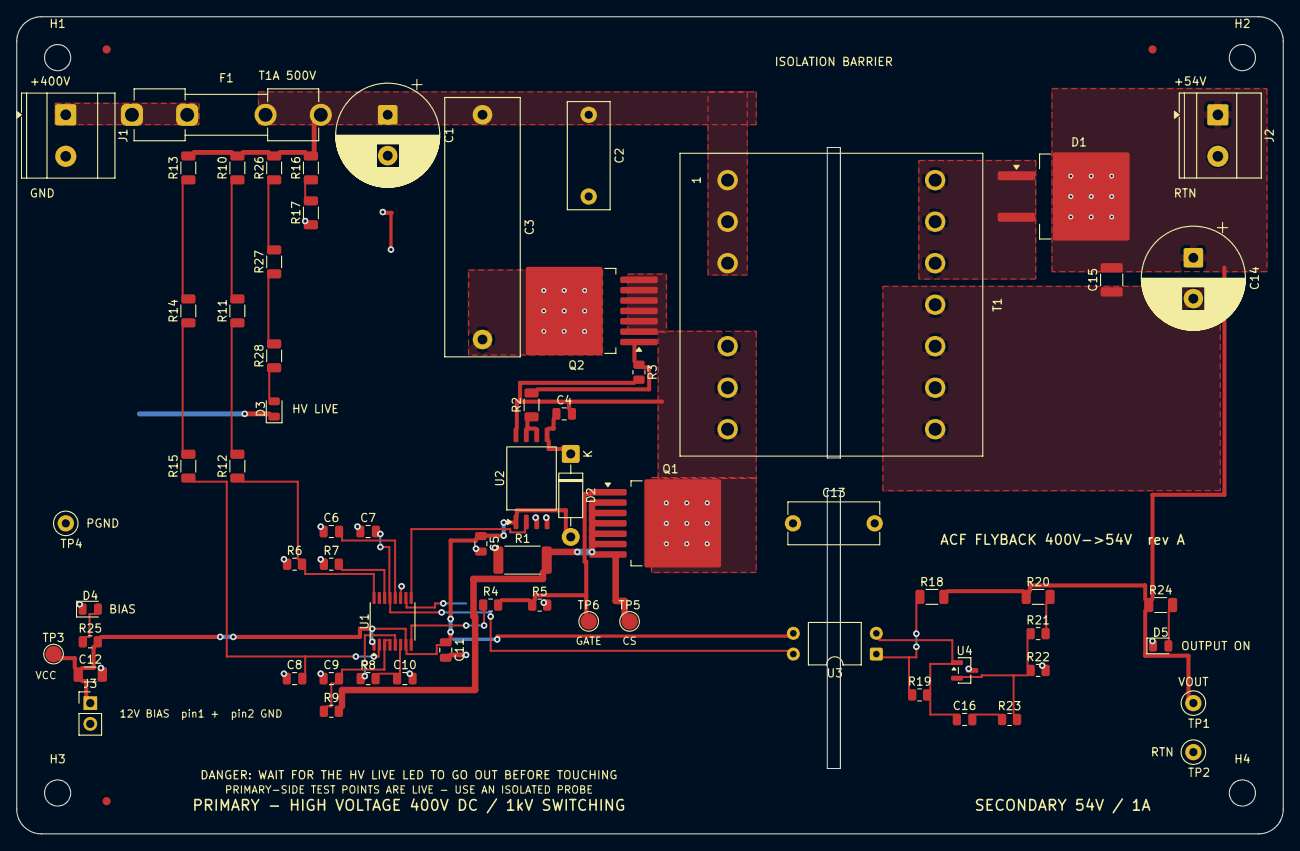
[picture p12: board ACF_Flyback.kicad_pcb from above]

Board: 2 copper layers, 155.0 x 100.0 mm, 76 parts (0 on the bottom side), 40 nets.

Other parts of the board:
ENC1: Enclosure base
ENC2: Enclosure lid
FID1, FID2, FID3: Fiducial; Fiducial_1mm_Mask2mm
